davidmlr/traction-hub/README.md

# traction-hub

ESC contrlled with stm32 

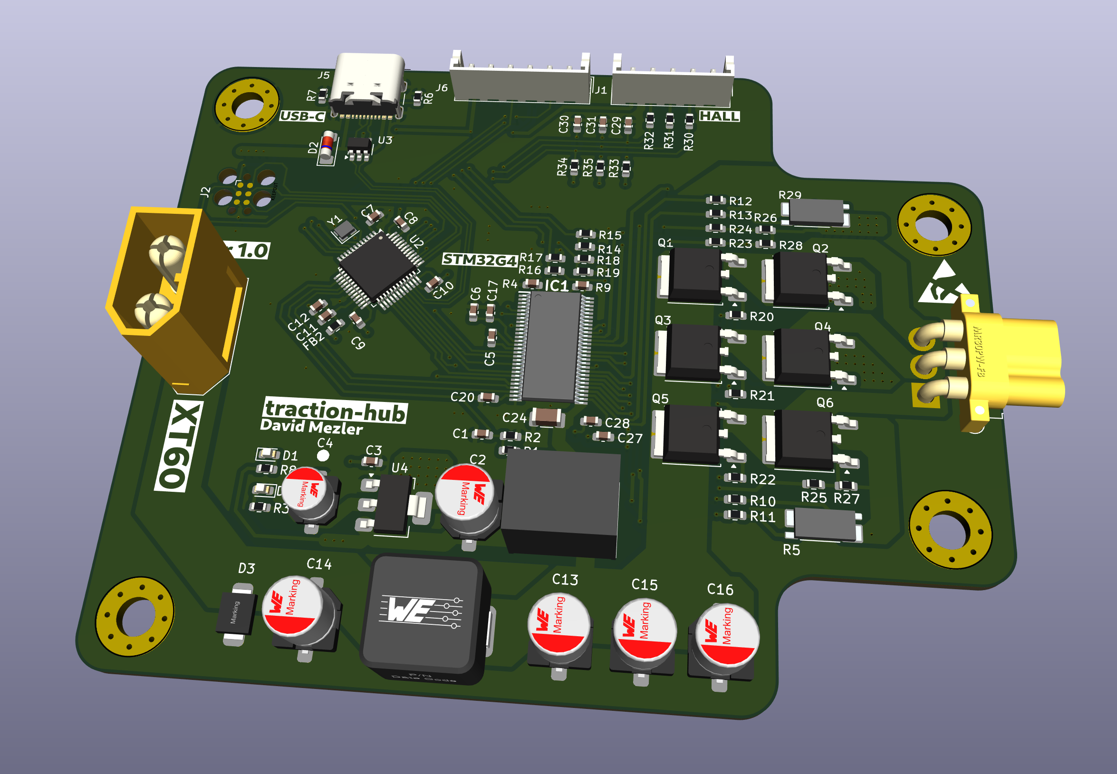
[picture p1: wip.png]
WIP
