davidmlr/traction-hub/pcb/parts_calc.ods

Part | Link | Count | Price [EUR/st] | Price [EUR] | Sheet
SMBJ30CA | https://mou.sr/4eUhp7Q | 2 | 0.33 € | 0.66 € | Power
100uF DC Link | https://mou.sr/3LeNh9F | 6 | 0.33 € | 1.98 €
1uH / 24A Choke | https://mou.sr/3S1jWU9 | 2 | 1.77 € | 3.54 €
4k7 0603 | https://mou.sr/45WTEIe | 2 | 0.13 € | 0.26 €
220uF / 10V | https://mou.sr/3WdTPvw | 2 | 0.33 € | 0.66 €
5V DC/DC | https://mou.sr/4bxqbG8 | 1 | 5.90 € | 5.90 €
5V LED Widerstand | https://mou.sr/4a1GCtu | 4 | 0.09 € | 0.36 €
5V LED | https://mou.sr/4bD2Bb3 | 2 | 0.18 € | 0.36 €
3.3 V LDO | https://mou.sr/3S2ixN1 | 2 | 0.92 € | 1.84 €
100u / 6.3V | https://mou.sr/3xZFUQn | 2 | 0.15 € | 0.30 €
0603 LED Grün | https://mou.sr/461STOo | 2 | 0.22 € | 0.44 €
N Mosfet | https://www.mouser.de/ProductDetail/Infineon-Technologies/IRFR7540TRPBF?qs=NBFAU1oqP4UDZQjtpL9DJA%3D%3D | 10 | 0.75 € | 7.50 € | Bridge
DRV8302 | https://mou.sr/3XUuBDF | 1 | 5.14 € | 5.14 € | Driver
XT60 PCB mount | https://www.tme.eu/de/details/xt60upb-m/dc-steckverbinder/amass/ | 2 | 0.69 € | 1.38 € | Root
Motor Connector | https://www.tme.eu/de/details/mr30pw-fb/dc-steckverbinder/amass/ | 1 | 0.79 € | 0.79 €
USB_C | https://www.mouser.de/ProductDetail/GCT/USB4105-GF-A-060?qs=QNEnbhJQKvY2mocwNJzgfA%3D%3D | 1 | 0.75 € | 0.75 €
Shunt | https://mou.sr/3W1da1X | 2 | 1.56 € | 3.12 €
 |  |  |  | 0.00 €
 |  |  |  | 0.00 €
 |  |  |  | 0.00 €
 |  |  |  | 0.00 €
 |  |  |  | 0.00 €
STM32 | https://mou.sr/4bJ0xhE | 1 | 5.68 € | 5.68 € | MCU
USB_ESD | https://mou.sr/3IqQ52c | 2 | 0.33 € | 0.66 €
24Mhz | https://mou.sr/4cUDQIj | 2 | 0.61 € | 1.22 €
Ferrit | https://mou.sr/4eVPynY | 2 | 0.29 € | 0.58 €
100nF 0603 10V | https://www.mouser.de/ProductDetail/Wurth-Elektronik/885012206020?qs=0KOYDY2FL29c%2FoFN5o3Exg%3D%3D | 10 | 0.05 € | 0.47 € | MISC
2u2 0603 16V | https://mou.sr/4byO6oJ | 10 | 0.10 € | 1.03 €
22nF 50V 0603 | https://mou.sr/3LDYVeJ | 3 | 0.09 € | 0.27 €
4u7 10V 0603 | https://mou.sr/3S4t0HH | 3 | 0.19 € | 0.57 €
220n 25V 0603 | https://mou.sr/3LkkX5W | 10 | 0.06 € | 0.59 €
10u 50V | https://mou.sr/4cDaoH6 | 1 | 2.08 € | 2.08 €
2n2 0603 50V | https://mou.sr/3zyHoBQ | 5 | 0.09 € | 0.47 €
4n7 0603 50V | https://mou.sr/4eYWzEA | 5 | 0.09 € | 0.47 €
0603 LED Yellow | https://mou.sr/4bD2Bb3 | 5 | 0.17 € | 0.85 €
1k 0603 | https://mou.sr/3W6DTKy | 2 | 0.21 € | 0.42 €
5R1 0603 | https://mou.sr/4eUSb9B | 2 | 0.13 € | 0.26 €
10k 0603 | https://mou.sr/4eXe9bQ | 10 | 0.11 € | 1.09 €
5k1 0603 | https://mou.sr/4eYV0WZ | 5 | 0.09 € | 0.47 €
150R 0603 | https://mou.sr/3Lg1N17 | 2 | 0.14 € | 0.28 €
1mohn 0603 | https://mou.sr/3S3D1F0 | 2 | 0.09 € | 0.19 €
100R 0603 | https://mou.sr/3Y3PbSp | 10 | 0.04 € | 0.42 €
39K 0603 | https://mou.sr/461Nkzk | 10 | 0.10 € | 0.95 €
2K2 0603 | https://mou.sr/4eZki7G | 10 | 0.01 € | 0.12 €
4R7 0603 | https://mou.sr/3VVecwl | 10 | 0.11 € | 1.11 €
 |  |  |  | 55.21 €
