davidmlr/traction-hub/pcb/3d/NX2016SA-24M-EXS00A-CS08891.stp

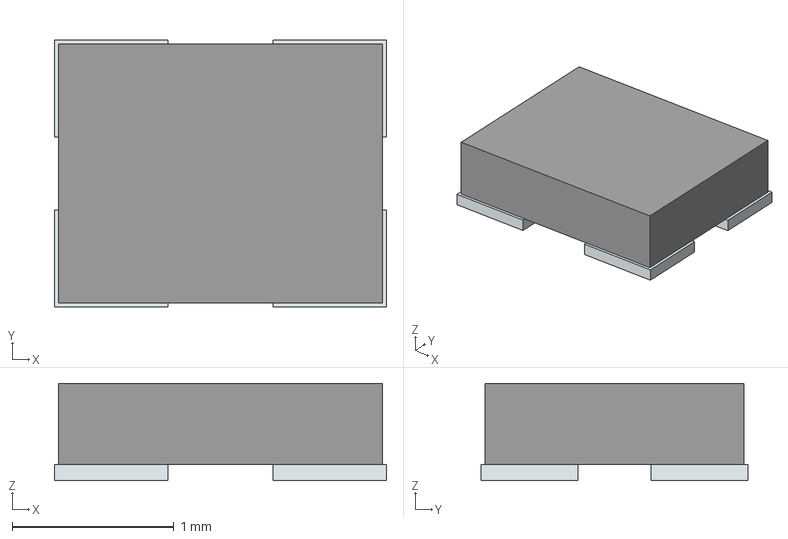
[picture p2: CAD file, 2024-07-10]
pcb/3d/NX2016SA-24M-EXS00A-CS08891.stp
2.05 x 1.65 x 0.6 mm
Pins
