davidmlr/traction-hub/pcb/3d/Amass MR30PW-FB.STEP

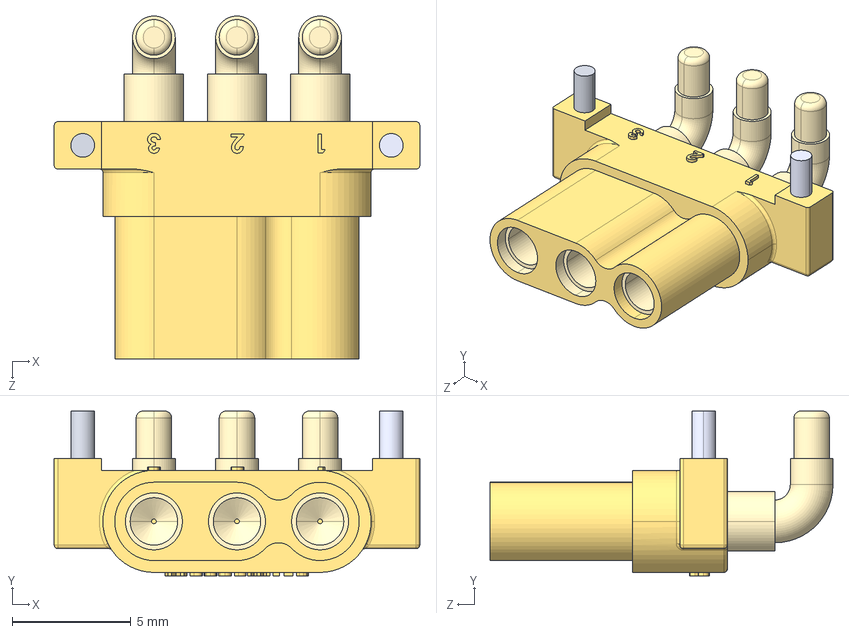
[picture p3: CAD file, 2024-07-10]
pcb/3d/Amass MR30PW-FB.STEP
15.4 x 6.95 x 14.5 mm
