davidmlr/traction-hub/pcb/3d/Download_STP_86508xx4200x (rev1).stp

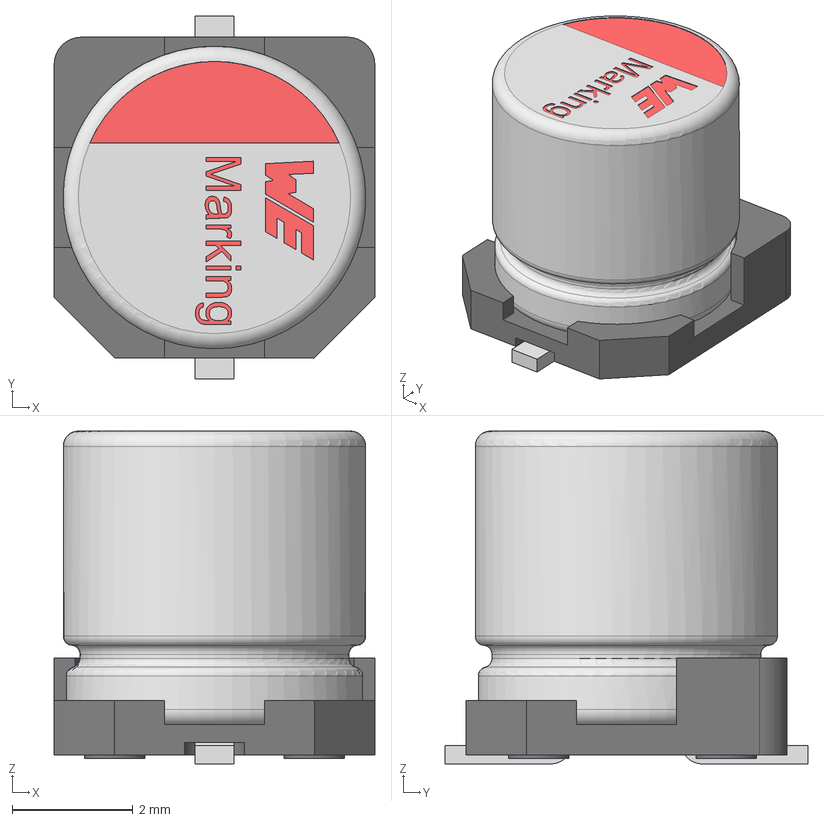
[picture p4: CAD file, 2024-07-10]
pcb/3d/Download_STP_86508xx4200x (rev1).stp
5.30 x 6.00 x 5.50 mm
capicitor_5x5.5x1.4
Base_Φ5Capacitor
