davidmlr/traction-hub/pcb/3d/DRV8302DCA.stp

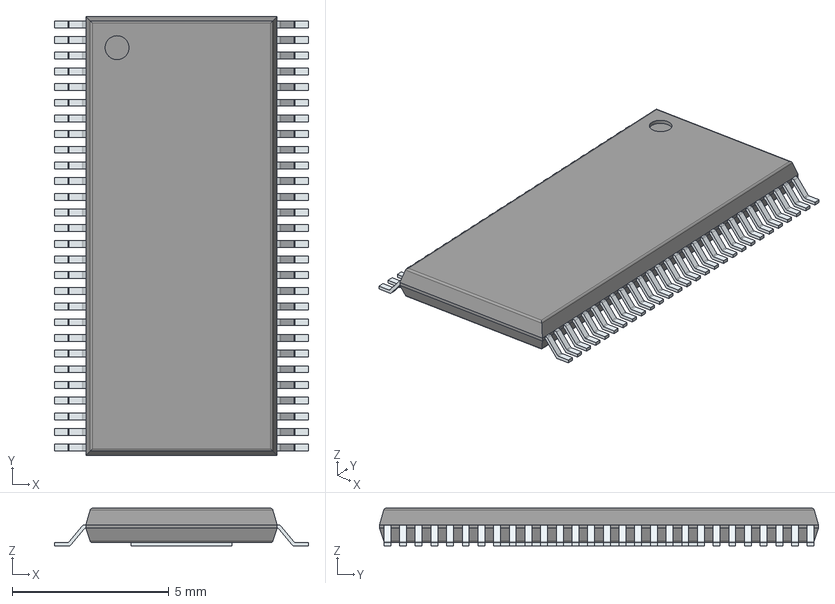
[picture p5: CAD file, 2024-07-10]
pcb/3d/DRV8302DCA.stp
8.10 x 14.0 x 1.20 mm
PinsArrayLR
ThermalPad
