davidmlr/traction-hub/pcb/3d/Download_STP_86508xx450xx (rev1).stp

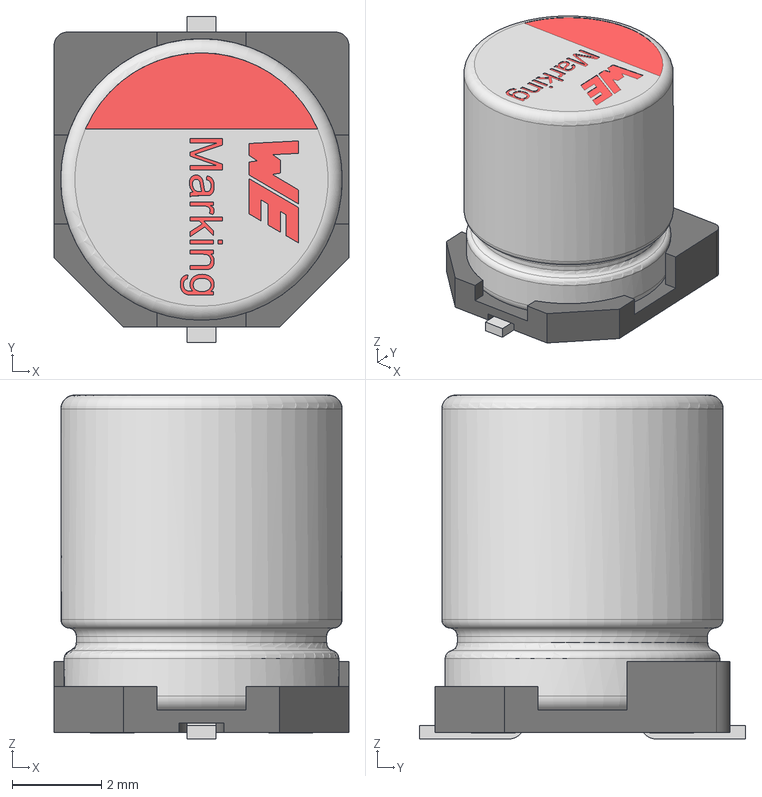
[picture p6: CAD file, 2024-07-09]
pcb/3d/Download_STP_86508xx450xx (rev1).stp
6.60 x 7.30 x 7.70 mm
capicitor_6.3x7.7x2.2
Base_Φ6_3Capacitor
