davidmlr/traction-hub/pcb/3d/Download_STP_WE-TVSP-DO-214AA-Bidirectional (rev1).stp

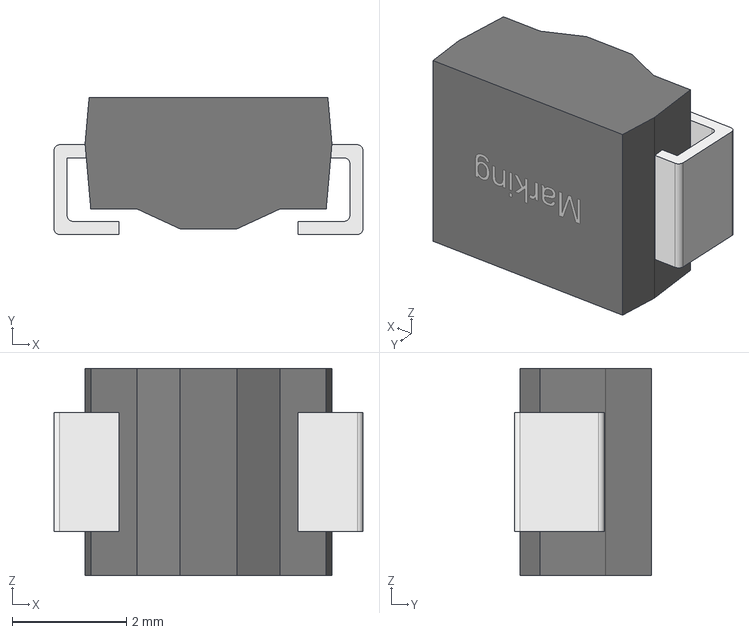
[picture p7: CAD file, 2024-07-09]
pcb/3d/Download_STP_WE-TVSP-DO-214AA-Bidirectional (rev1).stp
5.40 x 2.39 x 3.62 mm
