davidmlr/traction-hub/pcb/3d/WE-HCC-1210_FERRITE (rev1).stp

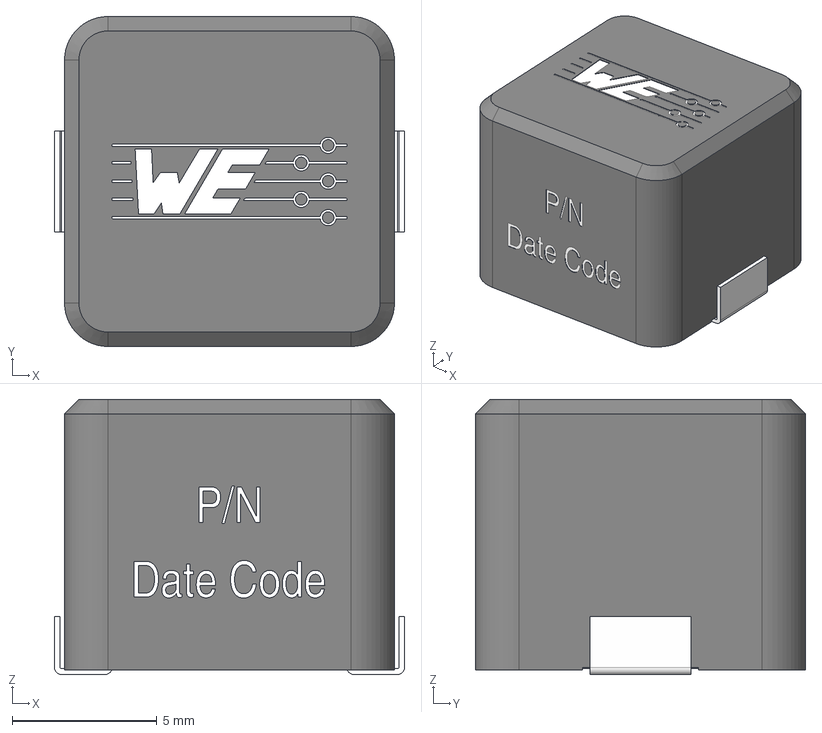
[picture p8: CAD file, 2024-07-09]
pcb/3d/WE-HCC-1210_FERRITE (rev1).stp
12.1 x 11.4 x 9.50 mm
base
core
contact
