davidmlr/traction-hub/pcb/3d/WSK25121L000FEA.stp

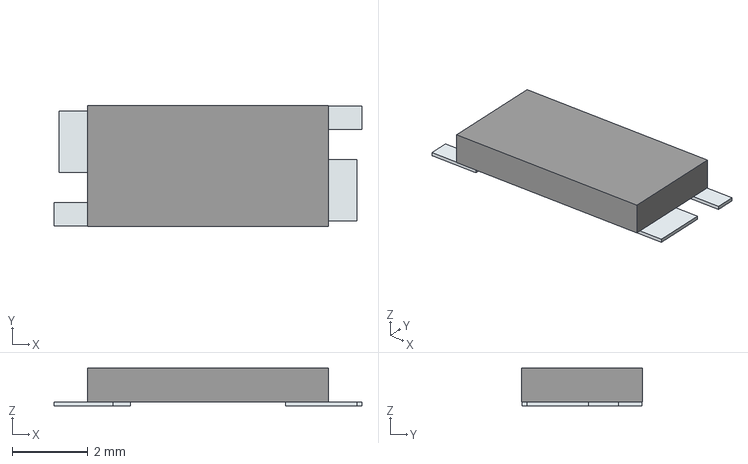
[picture p9: CAD file, 2024-07-10]
pcb/3d/WSK25121L000FEA.stp
8.11 x 3.18 x 0.989 mm
Pins
