davidmlr/traction-hub/pcb/TractionHub.kicad_pcb

## KiCad design pcb/TractionHub.kicad_pcb (2024-07-29)

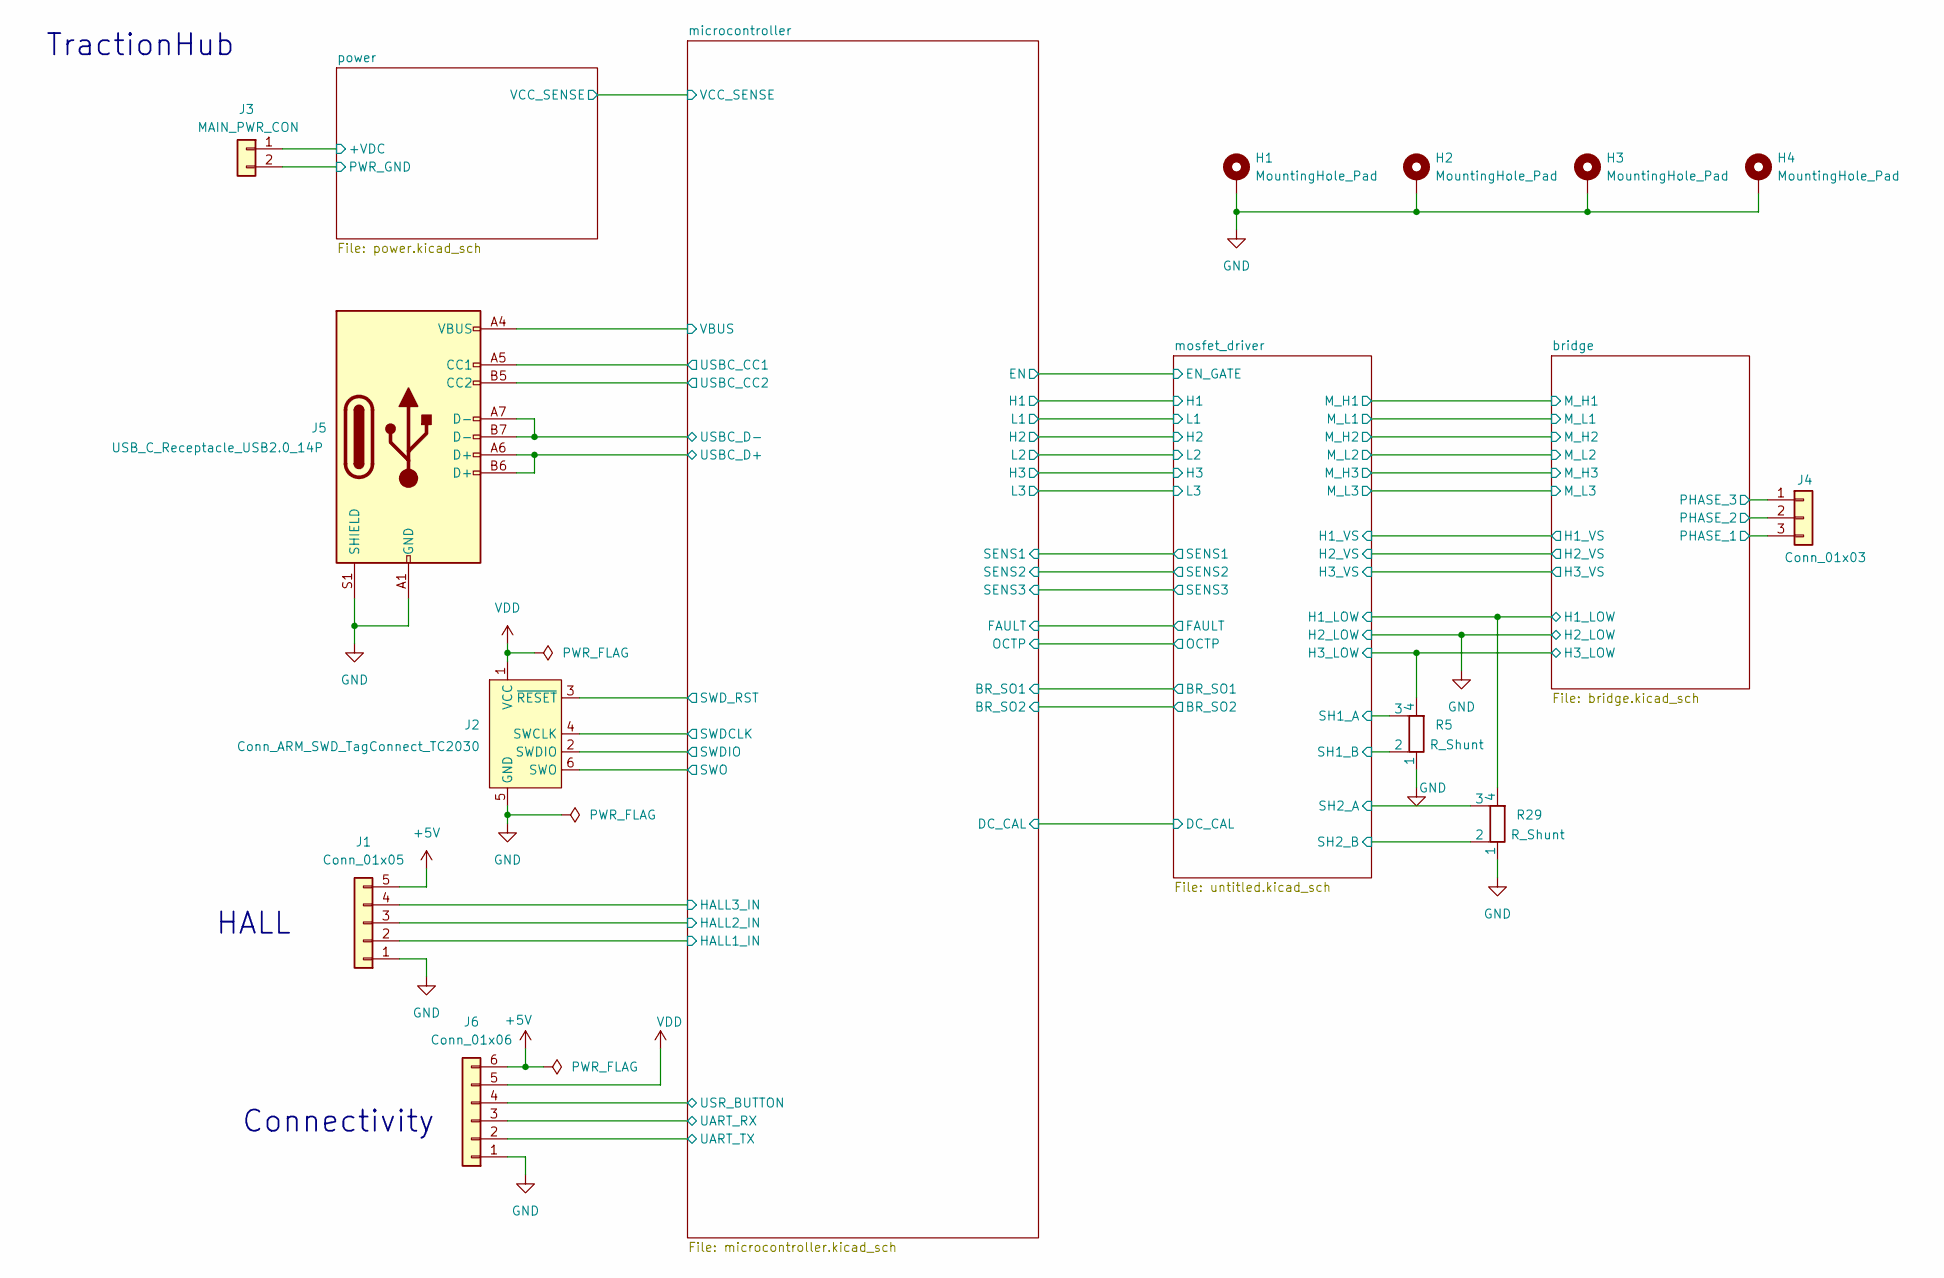
[picture p10: schematic TractionHub.kicad_sch, TractionHub V1]

Parts:
H1, H2, H3, H4: MountingHole_Pad; MountingHole_4.3mm_M4_Pad_Via
J1: Conn_01x05; JST_EH_B5B-EH-A_1x05_P2.50mm_Vertical
J2: Conn_ARM_SWD_TagConnect_TC2030; Tag-Connect_TC2030-IDC-FP_2x03_P1.27mm_Vertical
J3: MAIN_PWR_CON; AMASS_XT60-M_1x02_P7.20mm_Vertical
J4: Conn_01x03; cooler
J5: USB_C_Receptacle_USB2.0_14P; USB_C_Receptacle_GCT_USB4105-xx-A_16P_TopMnt_Horizontal
J6: Conn_01x06; JST_EH_B6B-EH-A_1x06_P2.50mm_Vertical
R5, R29: R_Shunt; besser

Connections:
+5V: J1.5, J6.6; also elsewhere on the board
/bridge/H1_LOW: R29.4; also elsewhere on the board
/bridge/H1_VS: J4.3; also elsewhere on the board
/bridge/H2_VS: J4.2; also elsewhere on the board
/bridge/H3_LOW: R5.4; also elsewhere on the board
/bridge/H3_VS: J4.1; also elsewhere on the board
/microcontroller/HALL1_IN: J1.2; also elsewhere on the board
/microcontroller/HALL2_IN: J1.3; also elsewhere on the board
/microcontroller/HALL3_IN: J1.4; also elsewhere on the board
/microcontroller/SWDCLK: J2.4 (SWCLK); also elsewhere on the board
/microcontroller/SWDIO: J2.2 (SWDIO); also elsewhere on the board
/microcontroller/SWD_RST: J2.3 (~RESET); also elsewhere on the board
/microcontroller/SWO: J2.6 (SWO); also elsewhere on the board
/microcontroller/UART_RX: J6.3; also elsewhere on the board
/microcontroller/UART_TX: J6.2; also elsewhere on the board
/microcontroller/USBC_CC1: J5.A5 (CC1); also elsewhere on the board
/microcontroller/USBC_CC2: J5.B5 (CC2); also elsewhere on the board
/microcontroller/USBC_D+: J5.A6 (D+), J5.B6 (D+); also elsewhere on the board
/microcontroller/USBC_D-: J5.A7 (D-), J5.B7 (D-); also elsewhere on the board
/microcontroller/USR_BUTTON: J6.4; also elsewhere on the board
/microcontroller/VBUS: J5.A4 (VBUS), J5.A9 (VBUS), J5.B4 (VBUS), J5.B9 (VBUS); also elsewhere on the board
/mosfet_driver/SH1_A: R5.3; also elsewhere on the board
/mosfet_driver/SH1_B: R5.2; also elsewhere on the board
/mosfet_driver/SH2_A: R29.3; also elsewhere on the board
/mosfet_driver/SH2_B: R29.2; also elsewhere on the board
/power/+VDC: J3.1; also elsewhere on the board
GND: H1.1, H2.1, H3.1, H4.1, J1.1, J2.5 (GND), J3.2, J5.A1 (GND), J5.A12 (GND), J5.B1 (GND), J5.B12 (GND), J5.S1 (SHIELD), J6.1, R5.1, R29.1; also elsewhere on the board
VDD: J2.1 (VCC), J6.5; also elsewhere on the board

Notes on the sheet:
HALL
TractionHub
Connectivity

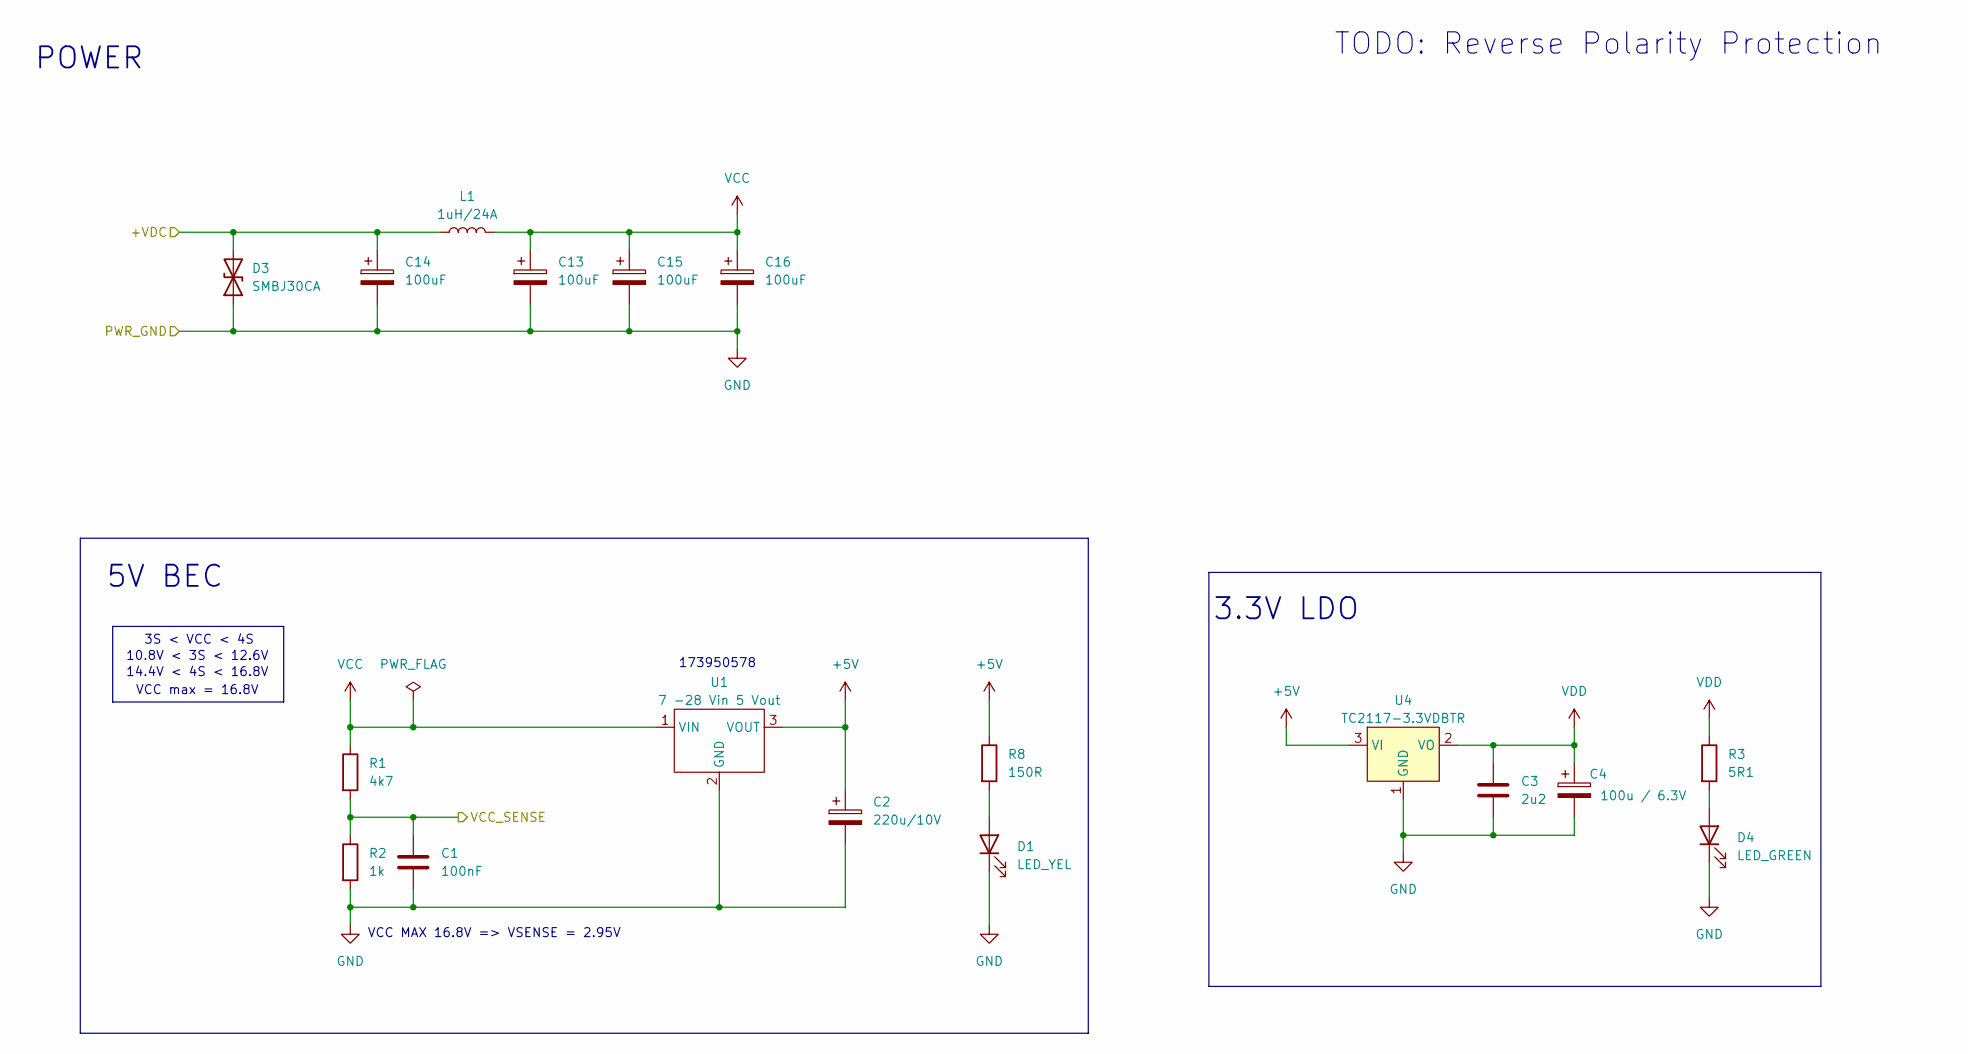
[picture p11: schematic power.kicad_sch, TractionHub V1]

Parts:
C1: 100nF; C_0603_1608Metric
C2: 220u/10V; 865080545012
C3: 2u2; C_0603_1608Metric
C4: 100u / 6.3V; 865080142007
C13, C14, C15, C16: 100uF; 865080545012
D1: LED_YEL; LED_0603_1608Metric
D3: SMBJ30CA; SMBJ33CA-824521331
D4: LED_GREEN; LED_0603_1608Metric
L1: 1uH/24A; 7443320100
R1: 4k7; R_0603_1608Metric
R2: 1k; R_0603_1608Metric
R3: 5R1; R_0603_1608Metric
R8: 150R; R_0603_1608Metric
U1: 7 -28 Vin 5 Vout; 173950578
U4: TC2117-3.3VDBTR; SOT-223-3_TabPin2

Connections:
+5V: C2.1, R8.1, U1.3 (VOUT), U4.3 (VI); also elsewhere on the board
/microcontroller/VCC_SENSE: C1.1, R1.2, R2.1; also elsewhere on the board
/power/+VDC: C14.1, D3.2 (A2), L1.1; also elsewhere on the board
GND: C1.2, C2.2, C3.2, C4.2, C13.2, C14.2, C15.2, C16.2, D1.1 (K), D3.1 (A1), D4.1 (K), R2.2, U1.2 (GND), U4.1 (GND); also elsewhere on the board
unnamed: D1.2 (A), R8.2
unnamed: D4.2 (A), R3.2
VCC: C13.1, C15.1, C16.1, L1.2, R1.1, U1.1 (VIN); also elsewhere on the board
VDD: C3.1, C4.1, R3.1, U4.2 (VO); also elsewhere on the board

Notes on the sheet:
5V BEC
POWER
3S < VCC < 4S
TODO: Reverse Polarity Protection
14.4V < 4S < 16.8V
10.8V < 3S < 12.6V
VCC MAX 16.8V => VSENSE = 2.95V
VCC max = 16.8V
3.3V LDO
173950578

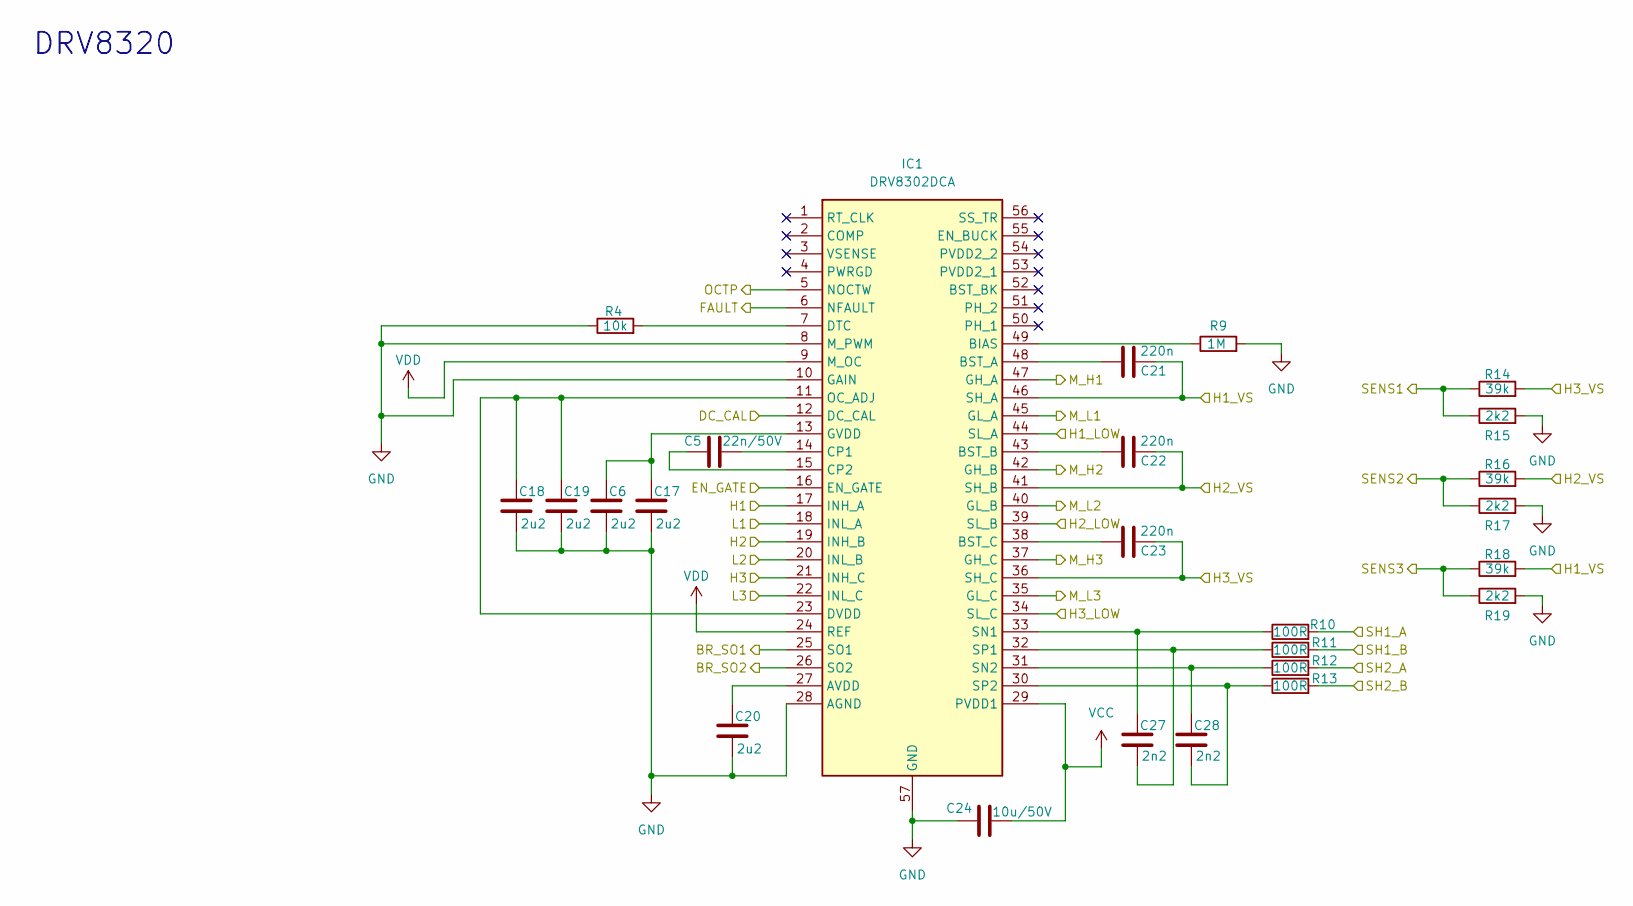
[picture p12: schematic untitled.kicad_sch]

Parts:
C5: 22n/50V; C_0603_1608Metric
C6, C17, C18, C19, C20: 2u2; C_0603_1608Metric
C21, C22, C23: 220n; C_0603_1608Metric
C24: 10u/50V; C_1206_3216Metric
C27, C28: 2n2; C_0603_1608Metric
IC1: DRV8302DCA; SOP50P810X120-57N; Mouser Part Number 595-DRV8302DCA
R4: 10k; C_0603_1608Metric
R9: 1M; C_0603_1608Metric
R10, R11, R12, R13: 100R; R_0603_1608Metric
R14, R16, R18: 39k; R_0603_1608Metric
R15, R17, R19: 2k2; R_0603_1608Metric

Connections:
/bridge/H1_LOW: IC1.44 (SL_A); also elsewhere on the board
/bridge/H1_VS: C21.2, IC1.46 (SH_A), R18.2; also elsewhere on the board
/bridge/H2_VS: C22.2, IC1.41 (SH_B), R16.2; also elsewhere on the board
/bridge/H3_LOW: IC1.34 (SL_C); also elsewhere on the board
/bridge/H3_VS: C23.2, IC1.36 (SH_C), R14.2; also elsewhere on the board
/bridge/M_H1: IC1.47 (GH_A); also elsewhere on the board
/bridge/M_H2: IC1.42 (GH_B); also elsewhere on the board
/bridge/M_H3: IC1.37 (GH_C); also elsewhere on the board
/bridge/M_L1: IC1.45 (GL_A); also elsewhere on the board
/bridge/M_L2: IC1.40 (GL_B); also elsewhere on the board
/bridge/M_L3: IC1.35 (GL_C); also elsewhere on the board
/microcontroller/BR_SO1: IC1.25 (SO1); also elsewhere on the board
/microcontroller/BR_SO2: IC1.26 (SO2); also elsewhere on the board
/microcontroller/DC_CAL: IC1.12 (DC_CAL); also elsewhere on the board
/microcontroller/EN: IC1.16 (EN_GATE); also elsewhere on the board
/microcontroller/FAULT: IC1.6 (NFAULT); also elsewhere on the board
/microcontroller/H1: IC1.17 (INH_A); also elsewhere on the board
/microcontroller/H2: IC1.19 (INH_B); also elsewhere on the board
/microcontroller/H3: IC1.21 (INH_C); also elsewhere on the board
/microcontroller/L1: IC1.18 (INL_A); also elsewhere on the board
/microcontroller/L2: IC1.20 (INL_B); also elsewhere on the board
/microcontroller/L3: IC1.22 (INL_C); also elsewhere on the board
/microcontroller/OCTP: IC1.5 (NOCTW); also elsewhere on the board
/microcontroller/SENS1: R14.1, R15.1; also elsewhere on the board
/microcontroller/SENS2: R16.1, R17.1; also elsewhere on the board
/microcontroller/SENS3: R18.1, R19.1; also elsewhere on the board
/mosfet_driver/SH1_A: R10.2; also elsewhere on the board
/mosfet_driver/SH1_B: R11.2; also elsewhere on the board
/mosfet_driver/SH2_A: R12.2; also elsewhere on the board
/mosfet_driver/SH2_B: R13.2; also elsewhere on the board
GND: C6.2, C17.2, C18.2, C19.2, C20.2, C24.1, IC1.8 (M_PWM), IC1.10 (GAIN), IC1.28 (AGND), IC1.39 (SL_B), IC1.57 (GND), R4.1, R9.2, R15.2, R17.2, R19.2; also elsewhere on the board
unnamed: C20.1, IC1.27 (AVDD)
unnamed: IC1.49 (BIAS), R9.1
unnamed: C21.1, IC1.48 (BST_A)
unnamed: C22.1, IC1.43 (BST_B)
unnamed: C23.1, IC1.38 (BST_C)
unnamed: C5.2, IC1.14 (CP1)
unnamed: C5.1, IC1.15 (CP2)
unnamed: IC1.7 (DTC), R4.2
unnamed: C18.1, C19.1, IC1.11 (OC_ADJ), IC1.23 (DVDD)
unnamed: C6.1, C17.1, IC1.13 (GVDD)
unnamed: C27.1, IC1.33 (SN1), R10.1
unnamed: C28.1, IC1.31 (SN2), R12.1
unnamed: C27.2, IC1.32 (SP1), R11.1
unnamed: C28.2, IC1.30 (SP2), R13.1
VCC: C24.2, IC1.29 (PVDD1); also elsewhere on the board
VDD: IC1.9 (M_OC), IC1.24 (REF); also elsewhere on the board

Notes on the sheet:
DRV8320

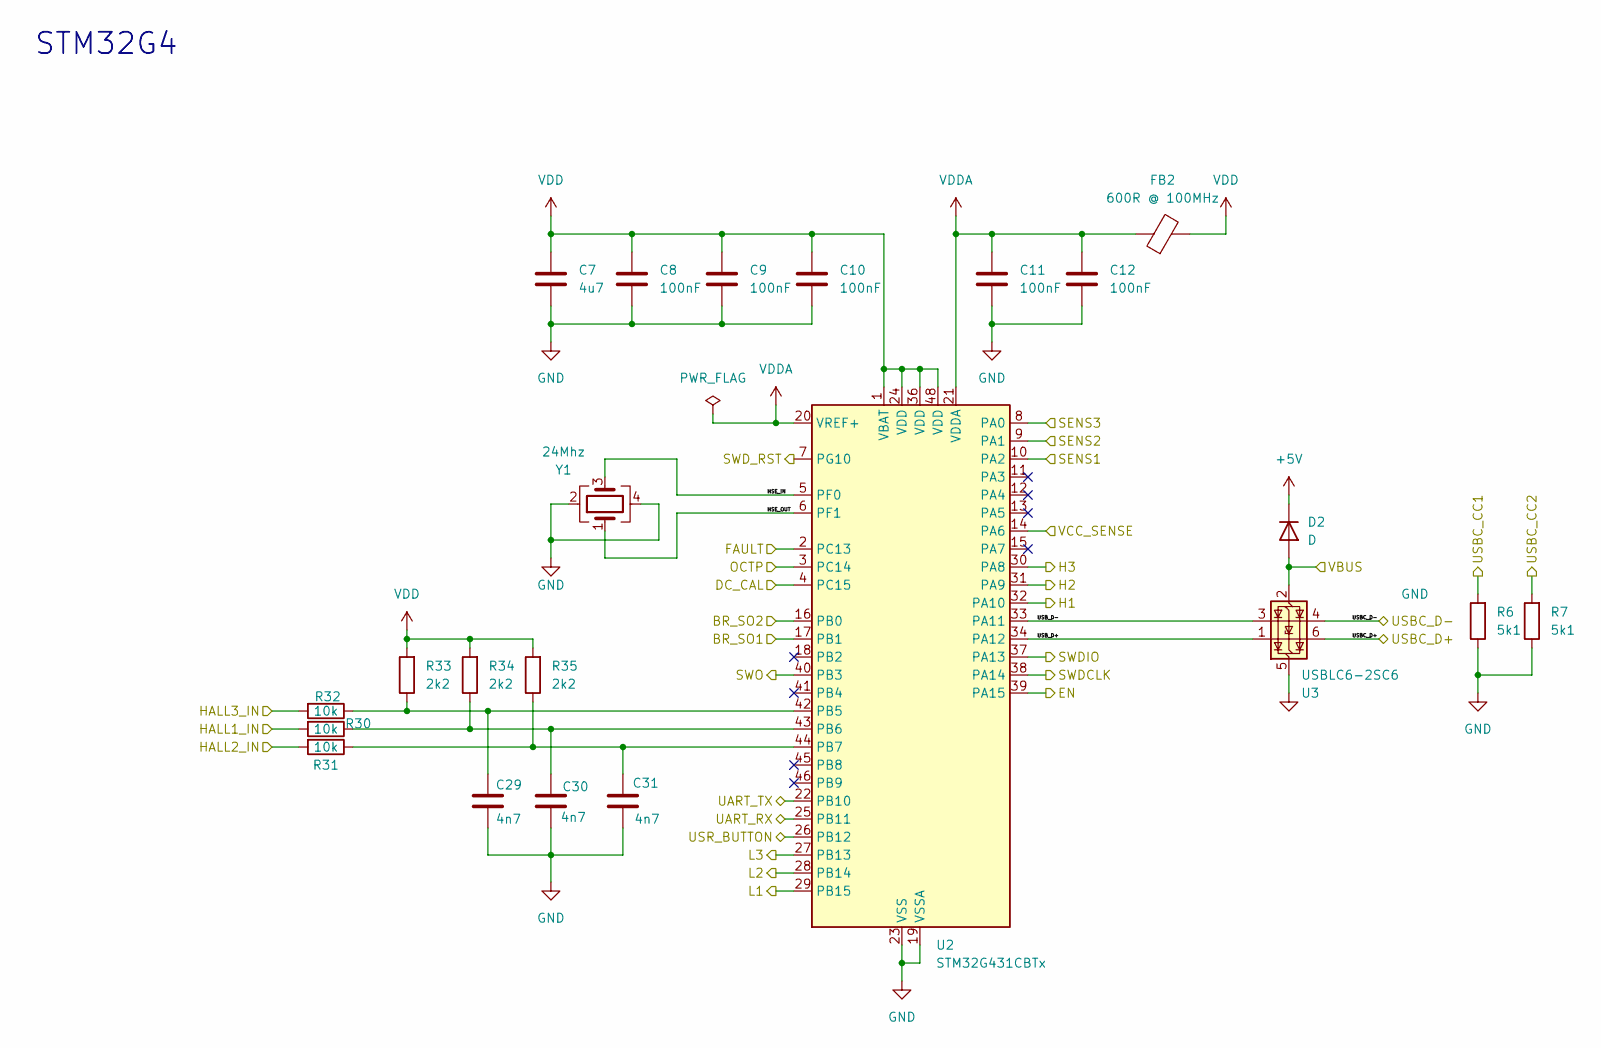
[picture p13: schematic microcontroller.kicad_sch]

Parts:
C7: 4u7; C_0603_1608Metric
C8, C9, C10, C11, C12: 100nF; C_0603_1608Metric
C29, C30, C31: 4n7; C_0603_1608Metric
D2: D; D_MiniMELF
FB2: 600R @ 100MHz; R_0603_1608Metric
R6, R7: 5k1; R_0603_1608Metric
R30, R31, R32: 10k; R_0603_1608Metric
R33, R34, R35: 2k2; R_0603_1608Metric
U2: STM32G431CBTx; LQFP-48_7x7mm_P0.5mm
U3: USBLC6-2SC6; SOT-23-6
Y1: 24Mhz; better_crystal

Connections:
+5V: D2.1 (K); also elsewhere on the board
/microcontroller/BR_SO1: U2.17 (PB1); also elsewhere on the board
/microcontroller/BR_SO2: U2.16 (PB0); also elsewhere on the board
/microcontroller/DC_CAL: U2.4 (PC15); also elsewhere on the board
/microcontroller/EN: U2.39 (PA15); also elsewhere on the board
/microcontroller/FAULT: U2.2 (PC13); also elsewhere on the board
/microcontroller/H1: U2.32 (PA10); also elsewhere on the board
/microcontroller/H2: U2.31 (PA9); also elsewhere on the board
/microcontroller/H3: U2.30 (PA8); also elsewhere on the board
/microcontroller/HALL1_IN: R30.2; also elsewhere on the board
/microcontroller/HALL2_IN: R31.2; also elsewhere on the board
/microcontroller/HALL3_IN: R32.2; also elsewhere on the board
/microcontroller/HSE_IN: U2.5 (PF0), Y1.3
/microcontroller/HSE_OUT: U2.6 (PF1), Y1.1
/microcontroller/L1: U2.29 (PB15); also elsewhere on the board
/microcontroller/L2: U2.28 (PB14); also elsewhere on the board
/microcontroller/L3: U2.27 (PB13); also elsewhere on the board
/microcontroller/OCTP: U2.3 (PC14); also elsewhere on the board
/microcontroller/SENS1: U2.10 (PA2); also elsewhere on the board
/microcontroller/SENS2: U2.9 (PA1); also elsewhere on the board
/microcontroller/SENS3: U2.8 (PA0); also elsewhere on the board
/microcontroller/SWDCLK: U2.38 (PA14); also elsewhere on the board
/microcontroller/SWDIO: U2.37 (PA13); also elsewhere on the board
/microcontroller/SWD_RST: U2.7 (PG10); also elsewhere on the board
/microcontroller/SWO: U2.40 (PB3); also elsewhere on the board
/microcontroller/UART_RX: U2.25 (PB11); also elsewhere on the board
/microcontroller/UART_TX: U2.22 (PB10); also elsewhere on the board
/microcontroller/USBC_CC1: R6.2; also elsewhere on the board
/microcontroller/USBC_CC2: R7.2; also elsewhere on the board
/microcontroller/USBC_D+: U3.6 (I/O1); also elsewhere on the board
/microcontroller/USBC_D-: U3.4 (I/O2); also elsewhere on the board
/microcontroller/USB_D+: U2.34 (PA12), U3.1 (I/O1)
/microcontroller/USB_D-: U2.33 (PA11), U3.3 (I/O2)
/microcontroller/USR_BUTTON: U2.26 (PB12); also elsewhere on the board
/microcontroller/VBUS: D2.2 (A), U3.2 (GND); also elsewhere on the board
/microcontroller/VCC_SENSE: U2.14 (PA6); also elsewhere on the board
GND: C7.2, C8.2, C9.2, C10.2, C11.2, C12.2, C29.2, C30.2, C31.2, R6.1, R7.1, U2.19 (VSSA), U2.23 (VSS), U2.35 (VSS), U2.47 (VSS), U3.5 (VBUS), Y1.2, Y1.4; also elsewhere on the board
unnamed: C29.1, R32.1, R33.1, U2.42 (PB5)
unnamed: C30.1, R30.1, R34.1, U2.43 (PB6)
unnamed: C31.1, R31.1, R35.1, U2.44 (PB7)
VDD: C7.1, C8.1, C9.1, C10.1, FB2.2, R33.2, R34.2, R35.2, U2.1 (VBAT), U2.24 (VDD), U2.36 (VDD), U2.48 (VDD); also elsewhere on the board
VDDA: C11.1, C12.1, FB2.1, U2.20 (VREF+), U2.21 (VDDA)

Notes on the sheet:
STM32G4

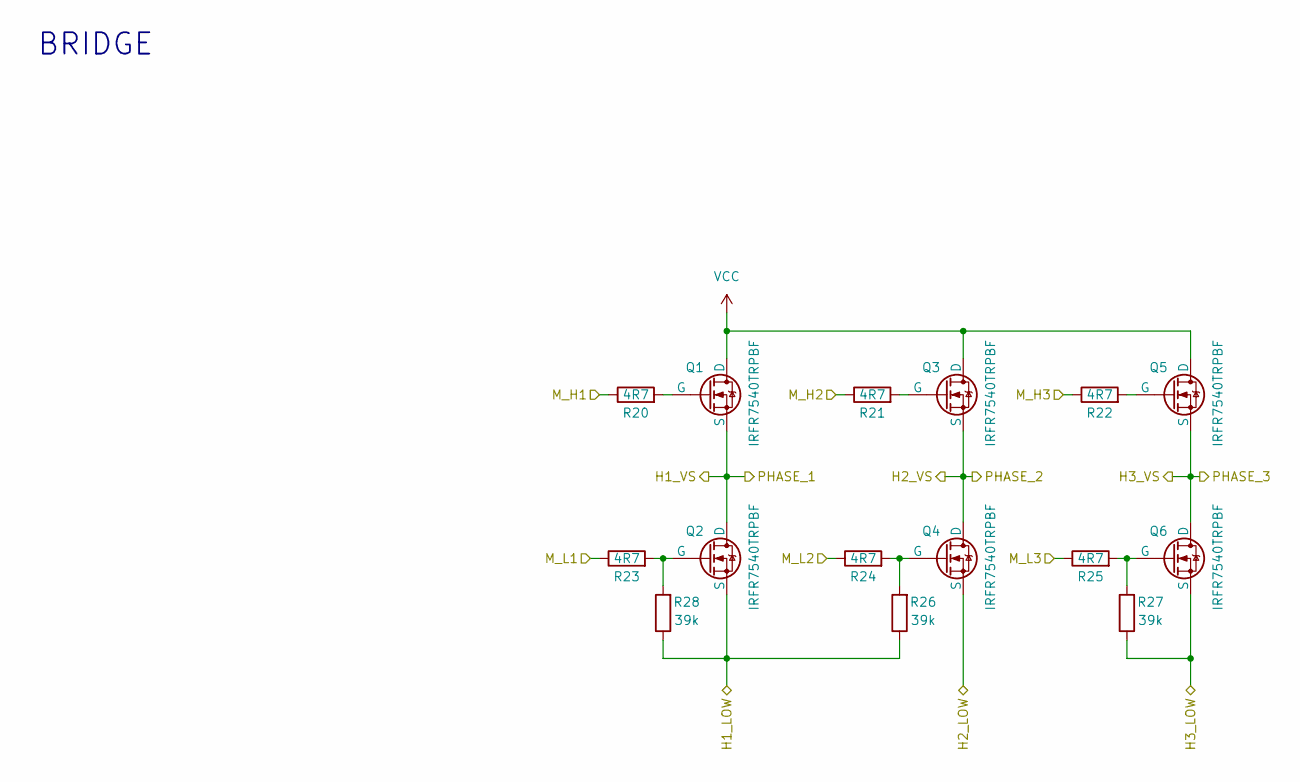
[picture p14: schematic bridge.kicad_sch]

Parts:
Q1, Q2, Q3, Q4, Q5, Q6: IRFR7540TRPBF; TO-252-2
R20, R21, R22, R23, R24, R25: 4R7; R_0603_1608Metric
R26, R27, R28: 39k; R_0603_1608Metric

Connections:
/bridge/H1_LOW: Q2.3 (S), R26.1, R28.1; also elsewhere on the board
/bridge/H1_VS: Q1.3 (S), Q2.2 (D); also elsewhere on the board
/bridge/H2_VS: Q3.3 (S), Q4.2 (D); also elsewhere on the board
/bridge/H3_LOW: Q6.3 (S), R27.1; also elsewhere on the board
/bridge/H3_VS: Q5.3 (S), Q6.2 (D); also elsewhere on the board
/bridge/M_H1: R20.1; also elsewhere on the board
/bridge/M_H2: R21.1; also elsewhere on the board
/bridge/M_H3: R22.1; also elsewhere on the board
/bridge/M_L1: R23.1; also elsewhere on the board
/bridge/M_L2: R24.1; also elsewhere on the board
/bridge/M_L3: R25.1; also elsewhere on the board
GND: Q4.3 (S); also elsewhere on the board
unnamed: Q1.1 (G), R20.2
unnamed: Q2.1 (G), R23.2, R28.2
unnamed: Q3.1 (G), R21.2
unnamed: Q4.1 (G), R24.2, R26.2
unnamed: Q5.1 (G), R22.2
unnamed: Q6.1 (G), R25.2, R27.2
VCC: Q1.2 (D), Q3.2 (D), Q5.2 (D); also elsewhere on the board

Notes on the sheet:
BRIDGE

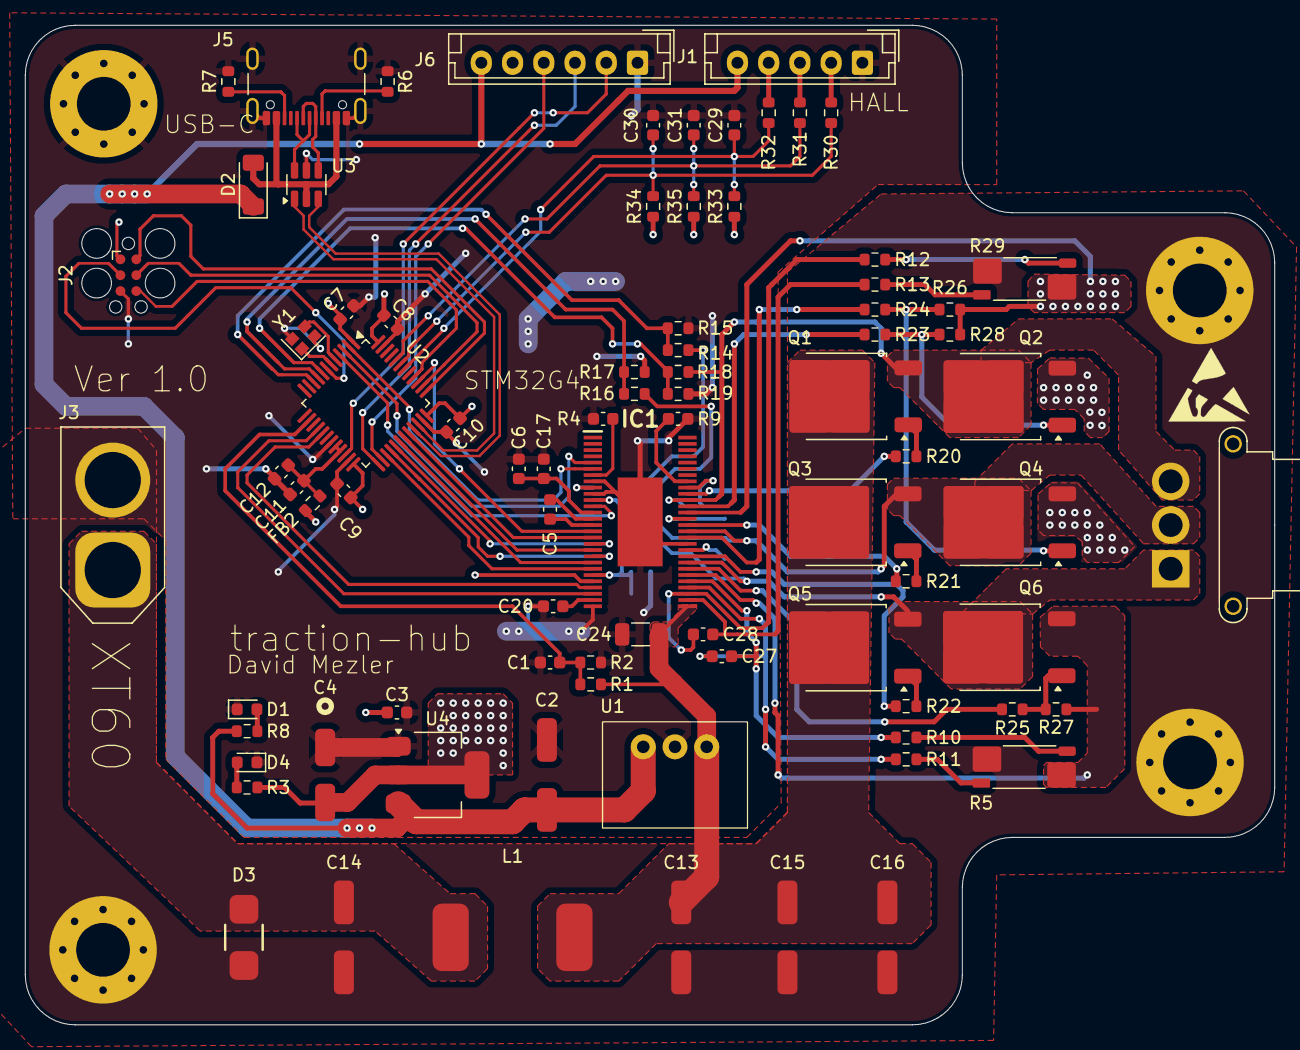
[picture p15: board TractionHub.kicad_pcb from above]

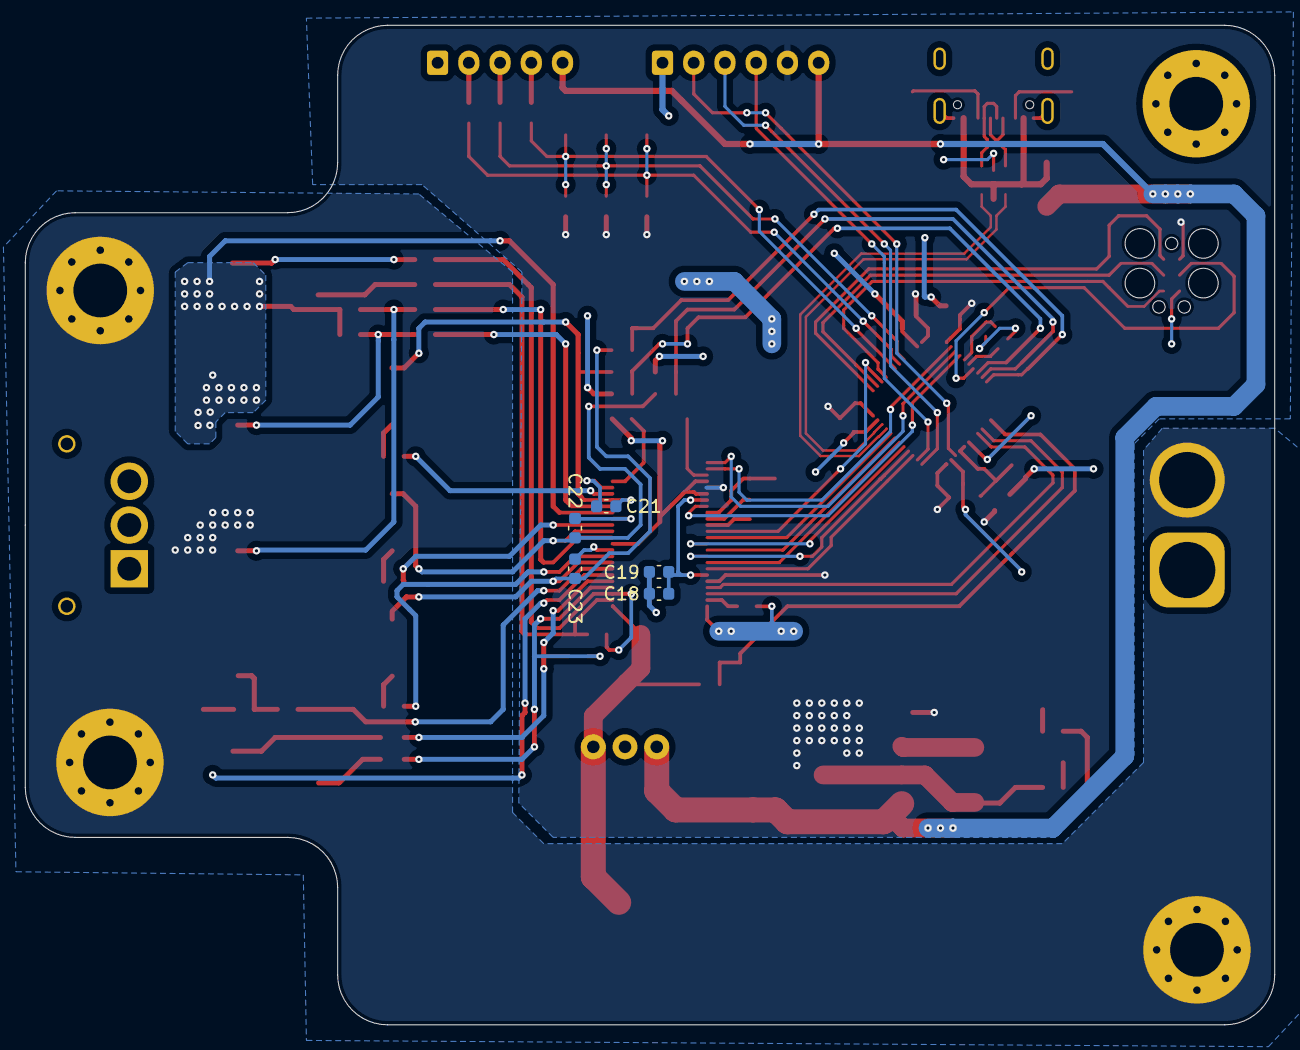
[picture p16: board TractionHub.kicad_pcb from below]

Board: 2 copper layers, 100.0 x 80.0 mm, 92 parts (5 on the bottom side), 81 nets.
