davidmlr/traction-hub/code/mcu/src/main.rs

#![no_std]
#![no_main]

mod fmt;

#[cfg(not(feature = "defmt"))]
use panic_halt as _;

#[cfg(feature = "defmt")]
use {defmt_rtt as _, panic_probe as _};

use embassy_executor::Spawner;
use embassy_stm32::time::Hertz;
use embassy_stm32::Config;
use fmt::info;

use system::resources::{AssignedResources, Usb, Voltage};

use task::{orchestrate::orchestrate, usb::usb, voltage::voltage};

/// System core modules
mod system;
/// Task implementation
mod task;

#[embassy_executor::main]
async fn main(spawner: Spawner) {
    let mut config = Config::default();
    {
        use embassy_stm32::rcc::*;
        config.rcc.hse = Some(Hse {
            freq: Hertz(24_000_000),
            mode: HseMode::Oscillator,
        });
        config.rcc.pll = Some(Pll {
            source: PllSource::HSE,
            prediv: PllPreDiv::DIV6,
            mul: PllMul::MUL85,
            divp: None,
            divq: None,
            // Main system clock at 170 MHz
            divr: Some(PllRDiv::DIV2),
        });
        config.rcc.mux.adc12sel = mux::Adcsel::SYS;
        config.rcc.sys = Sysclk::PLL1_R;
    }

    let p = embassy_stm32::init(config);

    let r = split_resources!(p);

    info!("traction-hub starting...");

    spawner.spawn(orchestrate()).unwrap();
    spawner.spawn(voltage(spawner, r.voltage)).unwrap();
    spawner.spawn(usb(spawner, r.usb)).unwrap();
}
