davidmlr/traction-hub/code/mcu/src/task/usb.rs

use crate::fmt::info;
use embassy_executor::Spawner;
use embassy_futures::join::join;
use embassy_stm32::usb::{Driver, Instance};
use embassy_usb::{
    class::cdc_acm::{CdcAcmClass, State},
    driver::EndpointError,
    Builder,
};

use crate::system::resources::{Irqs, Usb};

#[embassy_executor::task]
pub async fn usb(spawner: Spawner, r: Usb) {
    let driver = Driver::new(r.usb, Irqs, r.dp, r.dm);

    let mut config = embassy_usb::Config::new(0x0de, 0xcafe);
    config.manufacturer = Some("Davido Corp.");
    config.product = Some("traction-hub");
    config.serial_number = Some("00000001");
    config.max_power = 100;
    config.max_packet_size_0 = 64;

    // Create embassy-usb DeviceBuilder using the driver and config.
    // It needs some buffers for building the descriptors.
    let mut config_descriptor = [0; 256];
    let mut bos_descriptor = [0; 256];
    let mut control_buf = [0; 64];

    let mut state = State::new();

    let mut builder = Builder::new(
        driver,
        config,
        &mut config_descriptor,
        &mut bos_descriptor,
        &mut [],
        &mut control_buf,
    );

    let mut class = CdcAcmClass::new(&mut builder, &mut state, 64);

    let mut usb = builder.build();

    let usb_fut = usb.run();

    let echo_fut = async {
        loop {
            class.wait_connection().await;
            info!("Connected");
            class.split
            let _ = echo(&mut class).await;
            info!("Disconnected");
        }
    };

    join(usb_fut, echo_fut).await;
}

struct Disconnected {}

impl From<EndpointError> for Disconnected {
    fn from(val: EndpointError) -> Self {
        match val {
            EndpointError::BufferOverflow => panic!("Buffer overflow"),
            EndpointError::Disabled => Disconnected {},
        }
    }
}

async fn echo<'d, T: Instance + 'd>(
    class: &mut CdcAcmClass<'d, Driver<'d, T>>,
) -> Result<(), Disconnected> {
    let mut buf = [0; 64];
    loop {
        let n = class.read_packet(&mut buf).await?;
        let data = &buf[..n];
        info!("data: {:x}", data);
        class.write_packet(data).await?;
    }
}
