davidmlr/traction-hub/(commit log)

2024-06-12 add kicad project
    [TractionHub.kicad_pcb, TractionHub.kicad_sch]
2024-06-13 pcb: add regulators and stm32
    [TractionHub.kicad_sch, microcontroller.kicad_sch, power.kicad_sch]
2024-07-09 pcb: wip
    [Download_STP_86508xx450xx (rev1).stp, Download_STP_WE-TVSP-DO-214AA-Bidirectional (rev1).stp, TractionHub.kicad_sch, WE-HCC-1210_FERRITE (rev1).stp, microcontroller.kicad_sch, parts_calc.ods, power.kicad_sch]
2024-07-10 pcb: first version schematic
    [Amass MR30PW-FB.STEP, DRV8302DCA.stp, Download_STP_86508xx4200x (rev1).stp, NX2016SA-24M-EXS00A-CS08891.stp, TractionHub.kicad_pcb, TractionHub.kicad_sch, WSK25121L000FEA.stp, bridge.kicad_sch]
2024-07-11 pcb: complete bom and first layout
    [TractionHub.kicad_pcb, parts_calc.ods, power.kicad_sch, untitled.kicad_sch]
2024-07-11 pcb: plan_b ready for production
    [parts_calc.ods, stm32wb_breakout.kicad_pcb, stm32wb_breakout.kicad_sch]
2024-07-11 pcb: outlines ready
    [TractionHub.kicad_pcb, TractionHub.kicad_sch, bridge.kicad_sch]
2024-07-23 pcb: layout wip
    [TractionHub.kicad_pcb]
2024-07-26 pcb: layout power
    [TractionHub.kicad_pcb]
2024-07-28 pcb: layout gate driver
    [TractionHub.kicad_pcb, TractionHub.kicad_sch, power.kicad_sch]
2024-07-29 pcb: v1.0 layout finsihed
    [TractionHub-B_Cu.gbl, TractionHub-B_Mask.gbs, TractionHub-B_Paste.gbp, TractionHub-B_Silkscreen.gbo, TractionHub-Edge_Cuts.gm1, TractionHub-F_Cu.gtl, TractionHub-F_Mask.gts, TractionHub-F_Paste.gtp]
2024-07-29 pcb: remove kicad backups
2024-08-18 read in dc-link voltage
2024-09-06 code: add drv interfaces + simple switching test
2025-04-06 code: bldc running open loop
2025-04-06 add kicad .lck file to gitignore
2025-08-30 code: measure actual voltage
2026-06-29 feat: add open loop pwm control
2026-10-31 feat: first rudimentary phase current measuremnt
2026-11-01 feat: add protocol lib and log raw current adc samples over usb
2026-11-03 feat: stream 20kHz of current samples over usb :), write samples in csv
2026-11-03 feat: add own panic handler and disable pwm generation when core is halted
